G-Maveryck/OpenFlex-hardware/README.md

# OpenFlex-Project-hardware
Prototype for an Open source Flexfuel additionnal box
