G-Maveryck/OpenFlex-hardware/OpenFlex_Prototype/preview/Open_FlexFuel_Nano_THT_02.jpg

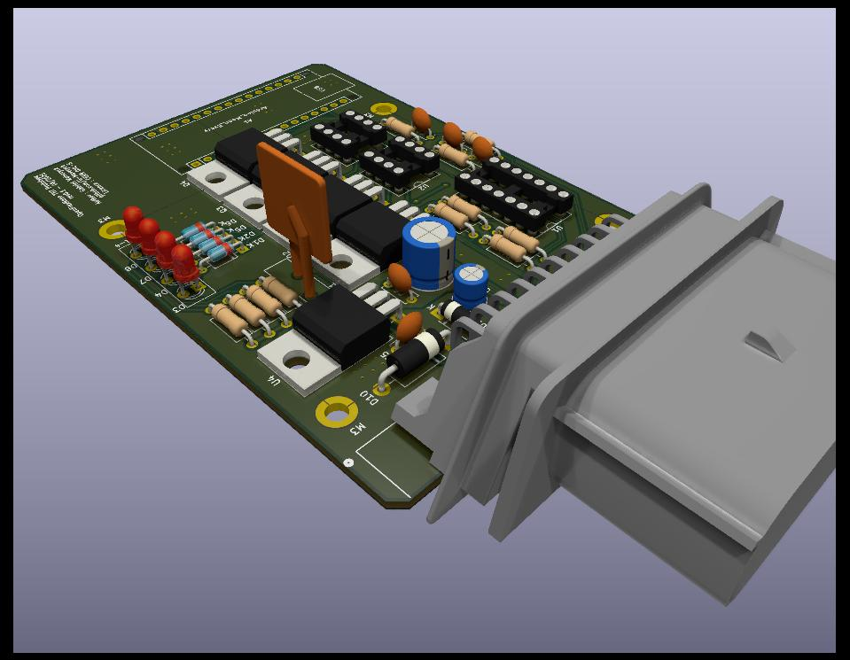
OpenFlex_Prototype/preview/Open_FlexFuel_Nano_THT_02.jpg
