G-Maveryck/OpenFlex-hardware/OpenFlex_Prototype/preview/Open_FlexFuel_Nano_THT_03.jpg

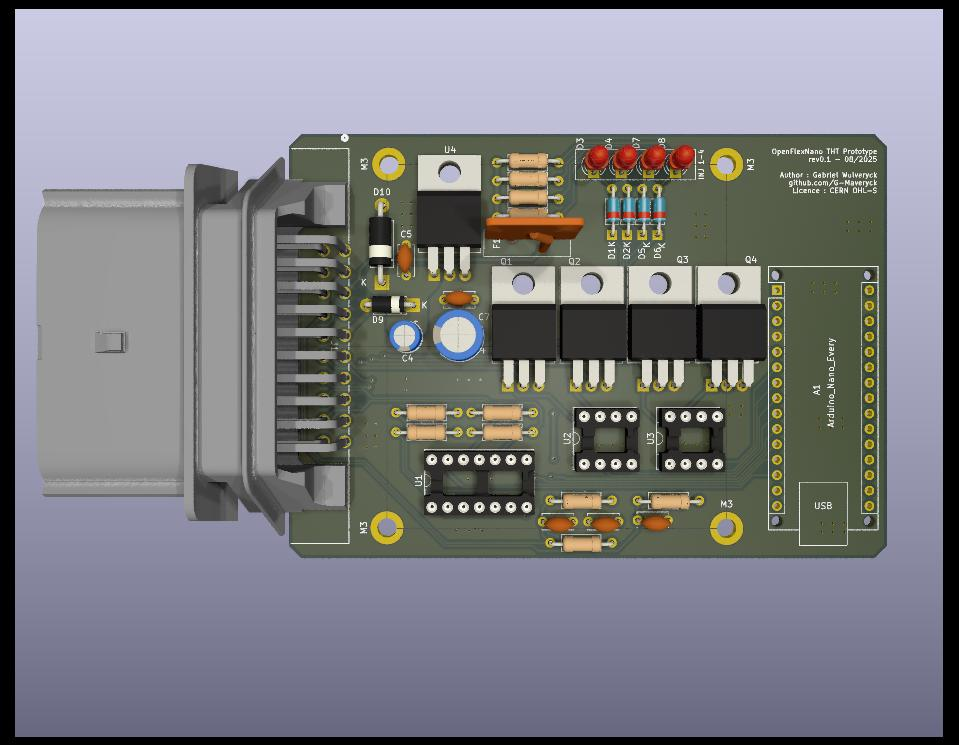
OpenFlex_Prototype/preview/Open_FlexFuel_Nano_THT_03.jpg
