G-Maveryck/OpenFlex-hardware/OpenFlex_Prototype/preview/Open_FlexFuel_Nano_THT_04.png

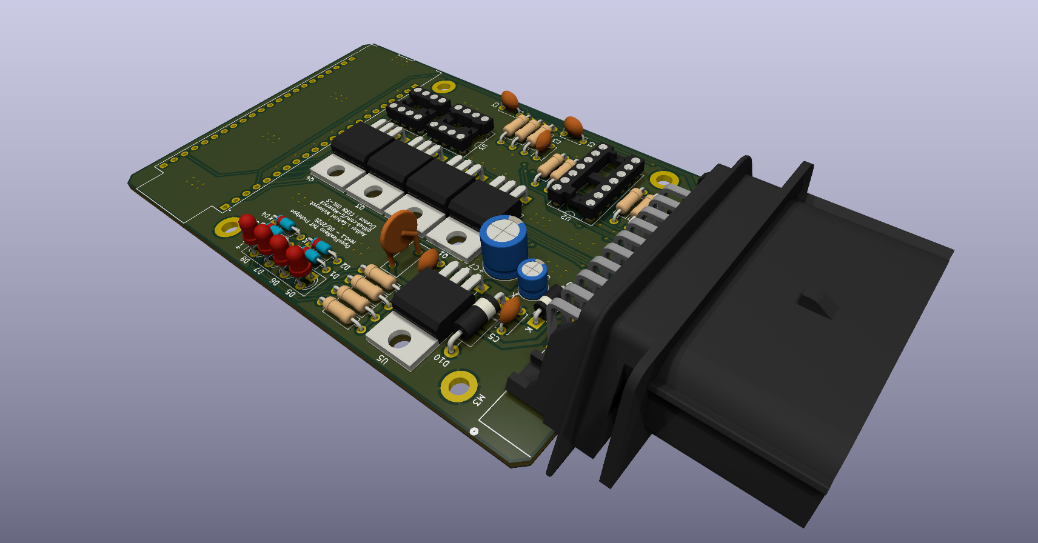
OpenFlex_Prototype/preview/Open_FlexFuel_Nano_THT_04.png
