G-Maveryck/OpenFlex-hardware/OpenFlex_Prototype/BOM_OpenFlex_Proto_THT.csv

Reference | Qty | Value | DNP | Exclude from BOM | Exclude from Board | Footprint | Datasheet | Manufacturer_Name | Mouser_Part_Number | Manufacturer_Part_Number | Mouser URL | Digikey_Part_Number
C1 | 1 | 100nF |  |  |  | Capacitor_THT:C_Disc_D5.0mm_W2.5mm_P5.00mm |  | TDK | 810-FA18X8R1E104KNU6 | FA18X8R1E104KNU06
C2,C3 | 2 | 220nF |  |  |  | Capacitor_THT:C_Disc_D5.0mm_W2.5mm_P5.00mm |  | TDK | 810-FA18X8R1E224KRU6 | FA18X8R1E224KRU06
C4 | 1 | 10uF |  |  |  | Capacitor_THT:CP_Radial_D5.0mm_P2.00mm |  | Panasonic | 667-EEU-FC1H100L | EEU-FC1H100L | https://www.mouser.fr/ProductDetail/Panasonic/EEU-FC1H100L?qs=y21It3NrCcwTwLLc39Q8Gg%3D%3D
C5,C6 | 2 | 0.1uF |  |  |  | Capacitor_THT:C_Disc_D5.0mm_W2.5mm_P5.00mm |  | TDK | 810-FA18X8R1E104KNU6 | FA18X8R1E104KNU06
C7 | 1 | 47uF |  |  |  | Capacitor_THT:CP_Radial_D8.0mm_P5.00mm |  | Panasonic | 667-EEU-FC1H470B | EEU-FC1H470B
D1,D2,D3,D4 | 4 | D |  |  |  | Diode_THT:D_DO-35_SOD27_P7.62mm_Horizontal |  | Vishay | 78-1N914-TAP,78-1N914-TAP | 1N914TAP
D5,D6,D7,D8 | 4 | LED |  |  |  | LED_THT:LED_D3.0mm |  | Wurth | 710-151031SS04000 | 151031SS04000
D9 | 1 | SB230-E3/54 |  |  |  | Diode_THT:D_DO-41_SOD81_P7.62mm_Horizontal | https://www.vishay.com/doc?88717 | Vishay Semiconductors | 625-SB230-E3 | SB230-E3/54 | https://www.mouser.fr/ProductDetail/Vishay-Semiconductors/SB230-E3-54?qs=u91jd7aysvMVfxBBDX1%252BYQ%3D%3D
D10 | 1 | TP6KE47A |  |  |  | Diode_THT:D_DO-15_P12.70mm_Horizontal |  | Littelfuse | 576-TP6KE47A | TP6KE47A
F1 | 1 | Polyfuse |  |  |  | Fuse:Fuse_BelFuse_0ZRE0005FF_L8.3mm_W3.8mm |  | Bel Fuse | 530-0ZRP0050FF1E | 0ZRP0050FF1E | https://www.mouser.fr/ProductDetail/Bel-Fuse/0ZRP0050FF1E?qs=gTYE2QTfZfSM60hMvV%252BG8g%3D%3D
J1 | 1 | Molex MAX150_2x10 |  |  | Exclure du PCB | Open_Flex_KiCadLibrary:Molex_CONN_MX150_20w |  | Molex | 538-33472-2001 | 33472-2001
J2 | 1 | Molex MAX150_2x10 |  |  |  | Open_Flex_KiCadLibrary:Molex_CONN_MX150_20w |  | Molex | 538-34830-2001 | 34830-2001
J3,J4,J5,J6,J7,J8,J9,J10,J11,J12,J13,J14,J15,J16,J17,J18,J19,J20,J21,J22 | 20 | Conn_01x01_Pin |  |  | Exclure du PCB |  |  | Molex | 538-33001-3004-LP | 33001-3004 (Loose Piece)
Q1,Q2,Q3,Q4 | 4 | STP80NF55-08 |  |  |  | Package_TO_SOT_THT:TO-220-3_Horizontal_TabDown |  | STMicroelectronics | 511-STP80NF55-08 | STP80NF55-08
R1,R2,R3,R4 | 4 | 10k |  |  |  | Resistor_THT:R_Axial_DIN0207_L6.3mm_D2.5mm_P10.16mm_Horizontal |  | YAGEO | 603-MFR-25FBF52-10K | MFR-25FBF52-10K
R5,R6,R7,R8 | 4 | 1k |  |  |  | Resistor_THT:R_Axial_DIN0207_L6.3mm_D2.5mm_P10.16mm_Horizontal |  | YAGEO | 603-MFR-25FBF52-1K | MFR-25FBF52-1K
R9 | 1 | 2.49k |  |  |  | Resistor_THT:R_Axial_DIN0207_L6.3mm_D2.5mm_P10.16mm_Horizontal |  | Stackpole Electronics Inc |  | RNF14BTE2K49 |  | 738-RNF14BTE2K49CT-ND
R10 | 1 | 470R |  |  |  | Resistor_THT:R_Axial_DIN0207_L6.3mm_D2.5mm_P10.16mm_Horizontal |  | YAGEO | 603-MFR-25FTE52-470R | MFR-25FTE52-470R
R11 | 1 | 2.4k |  |  |  | Resistor_THT:R_Axial_DIN0207_L6.3mm_D2.5mm_P10.16mm_Horizontal |  | Yageo | 603-MFR-25FBF52-2K4 | MFR-25FBF52-2K4
TH1 | 1 | 10k |  |  | Exclure du PCB |  |  | TDK |  | B57863S0103F040 |  | 495-2149-ND
U1 | 1 | ESP32-S2-DEVKITC-1 |  |  |  | Open_Flex_KiCadLibrary:MODULE_ESP32-S2-DEVKITC-1
U2 | 1 | LM324 |  |  |  | Package_DIP:DIP-14_W7.62mm_Socket | http://www.ti.com/lit/ds/symlink/lm2902-n.pdf | Texas Instrument | 595-LM324KAN | LM324KAN
U3,U4 | 2 | TC4424 |  |  |  | Package_DIP:DIP-8_W7.62mm_Socket |  | Microchip Technology | 579-TC4424AVPA | TC4424AVPA
U5 | 1 | LM2940S-5.0 |  |  |  | Package_TO_SOT_THT:TO-220-3_Horizontal_TabDown |  | Texas Instruments | 926-LM2940T-50/LF08 | LM2940T-5.0/LF08
