G-Maveryck/OpenFlex-hardware/OpenFlex_Enclosure/OpenFlex_Proto_Enclosure_rev0-2.FCStd

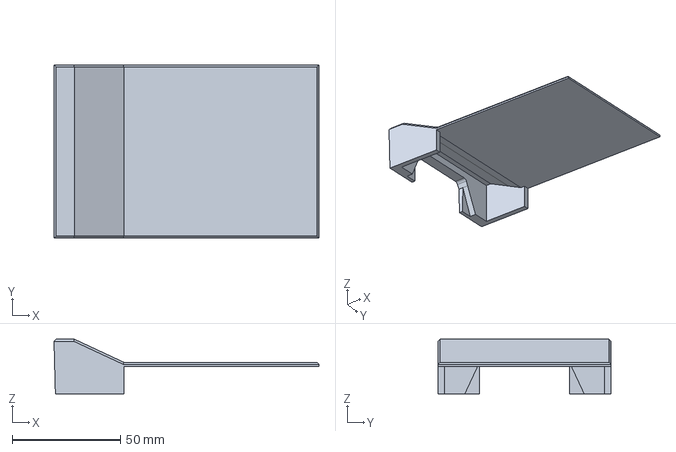
[picture p8: CAD file, 2026-08-11]
OpenFlex_Enclosure/OpenFlex_Proto_Enclosure_rev0-2.FCStd
122.3 x 79.9 x 25.2 mm
