G-Maveryck/OpenFlex-hardware/OpenFlex_Enclosure/OpenFlex_PCB.FCStd

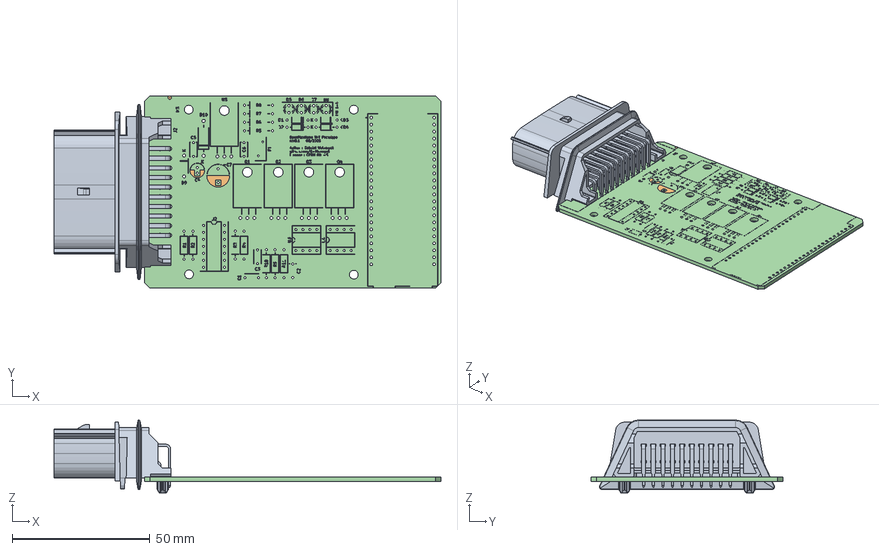
[picture p9: CAD file, 2026-07-14]
OpenFlex_Enclosure/OpenFlex_PCB.FCStd
140.7 x 69.9 x 26.5 mm
OpenFlex_Proto_THT_silkscreen
OpenFlex_Proto_THT_silkscreen001
OpenFlex_Proto_THT_PCB
