G-Maveryck/OpenFlex-hardware/OpenFlex_Enclosure/OpenFlex_Proto_PCB_rev0-2.step

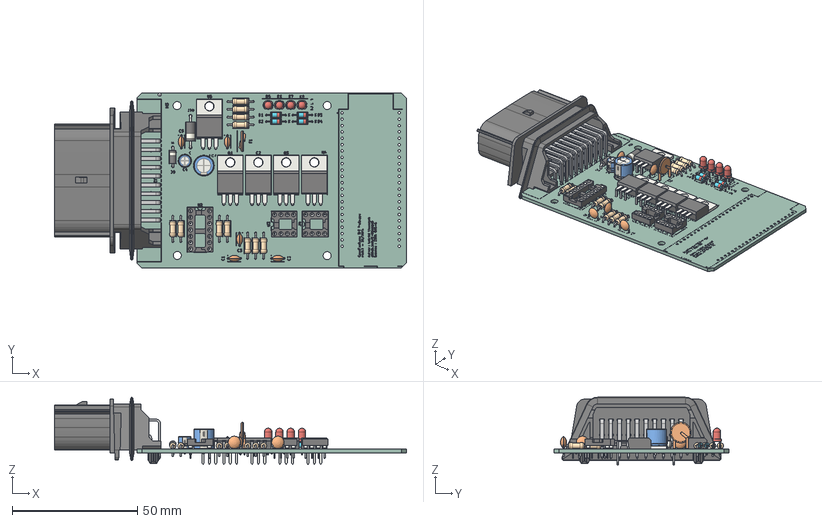
[picture p10: CAD file, 2026-07-14]
OpenFlex_Enclosure/OpenFlex_Proto_PCB_rev0-2.step
140.7 x 69.9 x 27.0 mm
DIP_8_W762mm_Socket x 2
D_DO-35_SOD27_P7.62mm_Horizontal x 4
CP_Radial_D50mm_P200mm
R_Axial_DIN0207_L63mm_D25mm_P1016mm_Horizontal x 11
TO-220-3_Horizontal_TabDown x 5
LED_D3.0mm x 4
C_Disc_D50mm_W25mm_P500mm x 5
D_DO-41_SOD81_P7.62mm_Horizontal
CP_Radial_D80mm_P500mm
D_DO-15_P12.70mm_Horizontal
A_0ZRE0005FF
DIP_14_W762mm_Socket
Open_FlexFuel_Nano_THT_silkscreen x 2
Open_FlexFuel_Nano_THT_PCB
