G-Maveryck/OpenFlex-hardware/OpenFlex_KiCadLibrary/3rdparty_stp/348302001.stp

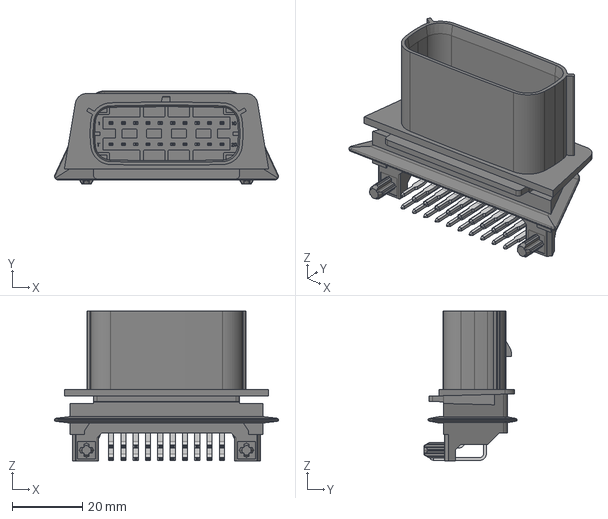
[picture p11: CAD file, 2026-04-27]
OpenFlex_KiCadLibrary/3rdparty_stp/348302001.stp
63.7 x 26.5 x 42.6 mm
