G-Maveryck/OpenFlex-hardware/(list of files, cad)

Other CAD files:
OpenFlex_Enclosure/ASS_OpenFlex.FCStd
OpenFlex_Enclosure/OpenFlex_Proto_PCB_rev0-2_Conn.step
