G-Maveryck/OpenFlex-hardware/OpenFlex_Prototype/OpenFlex_Proto_THT.kicad_pcb

## KiCad design OpenFlex_Prototype/OpenFlex_Proto_THT.kicad_pcb (2026-07-14)

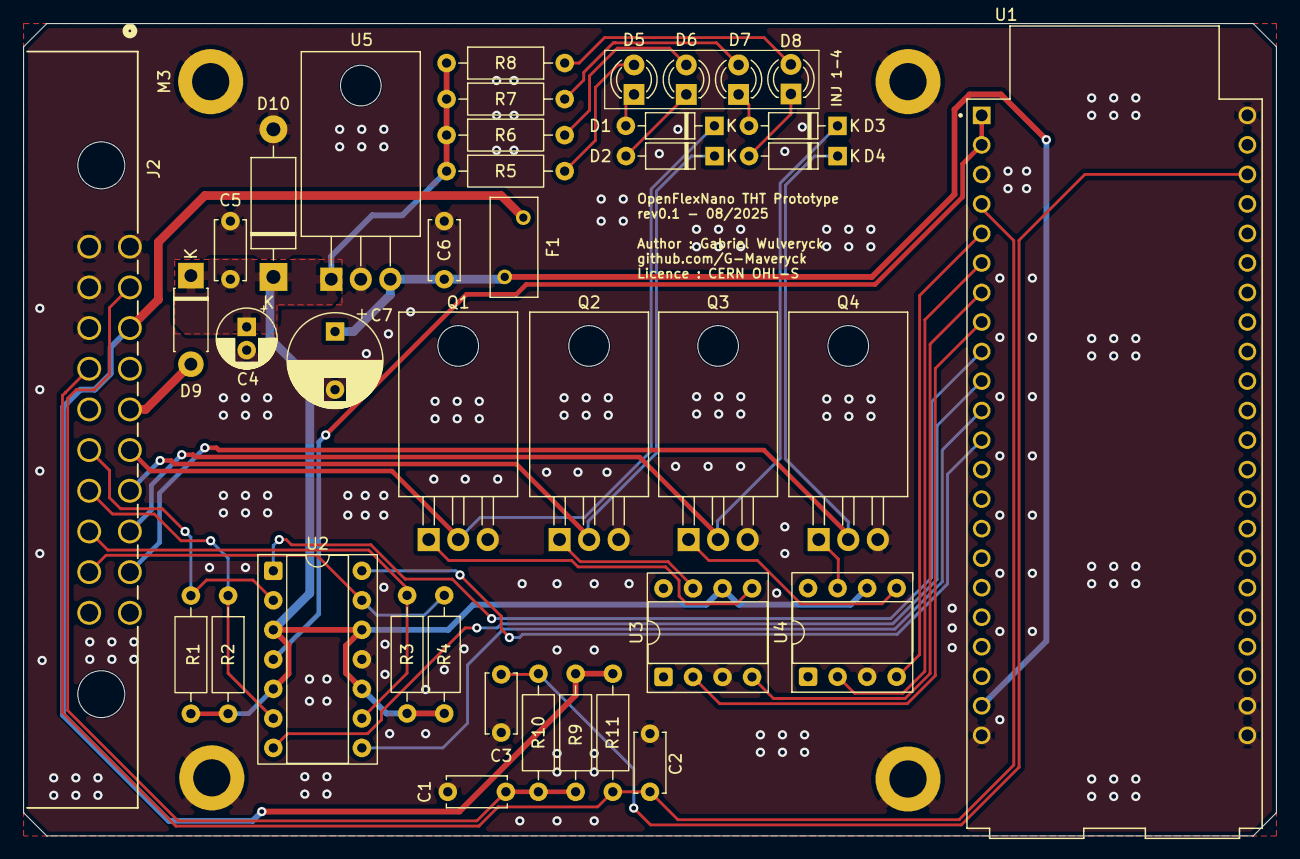
[picture p12: board OpenFlex_Proto_THT.kicad_pcb from above]

Board: 2 copper layers, 107.8 x 69.9 mm, 43 parts (0 on the bottom side), 37 nets.

Parts:
C1: 100nF; C_Disc_D5.0mm_W2.5mm_P5.00mm
C2, C3: 220nF; C_Disc_D5.0mm_W2.5mm_P5.00mm
C4: 10uF; CP_Radial_D5.0mm_P2.00mm
C5, C6: 0.1uF; C_Disc_D5.0mm_W2.5mm_P5.00mm
C7: 47uF; CP_Radial_D8.0mm_P5.00mm
D1, D2, D3, D4: D; D_DO-35_SOD27_P7.62mm_Horizontal
D5, D6, D7, D8: LED; LED_D3.0mm
D9: SB230-E3/54; D_DO-41_SOD81_P7.62mm_Horizontal
D10: TP6KE47A; D_DO-15_P12.70mm_Horizontal
F1: Polyfuse; Fuse_BelFuse_0ZRE0005FF_L8.3mm_W3.8mm
J2: Molex MAX150_2x10; Molex_CONN_MX150_20w
M3, M3#2, M3#3, M3#4: MountingHole_3.2mm_M3_DIN965_Pad
Q1, Q2, Q3, Q4: STP80NF55-08; TO-220-3_Horizontal_TabDown
R1, R2, R3, R4: 10k; R_Axial_DIN0207_L6.3mm_D2.5mm_P10.16mm_Horizontal
R5, R6, R7, R8: 1k; R_Axial_DIN0207_L6.3mm_D2.5mm_P10.16mm_Horizontal
R9: 2.49k; R_Axial_DIN0207_L6.3mm_D2.5mm_P10.16mm_Horizontal
R10: 470R; R_Axial_DIN0207_L6.3mm_D2.5mm_P10.16mm_Horizontal
R11: 2.4k; R_Axial_DIN0207_L6.3mm_D2.5mm_P10.16mm_Horizontal
U1: ESP32-S2-DEVKITC-1; MODULE_ESP32-S2-DEVKITC-1
U2: LM324; DIP-14_W7.62mm_Socket
U3, U4: TC4424; DIP-8_W7.62mm_Socket
U5: LM2940S-5.0; TO-220-3_Horizontal_TabDown

Connections:
+12V: C4.1, C5.1, D9.1 (K), D10.1 (K), R1.2, R2.2, R3.2, R4.2, R5.1, R6.1, R7.1, R8.1, U2.3 (+), U2.5 (+), U2.10 (+), U2.12 (+), U3.6 (VDD), U4.6 (VDD), U5.1 (VI)
/Connector/Flex_snsr_SIGN: C2.1, J2.14, R11.2, U1.J1_4 (GPIO4)
/Connector/INJ_+12V: D9.2 (A), J2.5
/Connector/INJ_CH1: J2.16, R1.1, U2.2 (-)
/Connector/INJ_CH2: J2.17, R2.1, U2.6 (-)
/Connector/INJ_CH3: J2.18, R3.1, U2.9 (-)
/Connector/INJ_CH4: J2.19, R4.1, U2.13 (-)
/Connector/INJ_DRIVE_CH1: D1.1 (K), J2.6, Q1.2 (D)
/Connector/INJ_DRIVE_CH2: D2.1 (K), J2.7, Q2.2 (D)
/Connector/INJ_DRIVE_CH3: D3.1 (K), J2.8, Q3.2 (D)
/Connector/INJ_DRIVE_CH4: D4.1 (K), J2.9, Q4.2 (D)
/Connector/Temp_snsr_V+: C1.1, J2.2, R9.1, R10.2
/IO_Drivers/INJ_SIGNAL_CH1: U1.J1_9 (GPIO16), U2.1
/IO_Drivers/INJ_SIGNAL_CH2: U1.J1_10 (GPIO17), U2.7
/IO_Drivers/INJ_SIGNAL_CH3: U1.J1_11 (GPIO18), U2.8
/IO_Drivers/INJ_SIGNAL_CH4: U1.J1_12 (GPIO8), U2.14
/IO_Drivers/MCU_INJ1: U1.J1_7 (GPIO7), U3.4 (IN_B)
/IO_Drivers/MCU_INJ2: U1.J1_8 (GPIO15), U3.2 (IN_A)
/IO_Drivers/MCU_INJ3: U1.J1_5 (GPIO5), U4.4 (IN_B)
/IO_Drivers/MCU_INJ4: U1.J1_6 (GPIO6), U4.2 (IN_A)
/IO_Drivers/Temp_Signal: C3.1, R10.1, U1.J3_3 (U0RXD)
GND: C1.2, C2.2, C3.2, C4.2, C5.2, C6.2, C7.2, D10.2 (A), J2.1, J2.11, J2.12, J2.13, M3.1, M3#2.1, M3#3.1, M3#4.1, Q1.3 (S), Q2.3 (S), Q3.3 (S), Q4.3 (S), U1.J1_22 (GND_J1_22), U1.J3_1 (GND_J3_1), U1.J3_21 (GND_J3_21), U1.J3_22 (GND_J3_22), U2.11 (V-), U3.3 (GND), U4.3 (GND), U5.2 (GND)
unnamed: D1.2 (A), D5.1 (K)
unnamed: D2.2 (A), D6.1 (K)
unnamed: D3.2 (A), D7.1 (K)
unnamed: D4.2 (A), D8.1 (K)
unnamed: D5.2 (A), R5.2
unnamed: D6.2 (A), R6.2
unnamed: D7.2 (A), R7.2
unnamed: D8.2 (A), R8.2
unnamed: Q1.1 (G), U3.5 (OUT_B)
unnamed: Q2.1 (G), U3.7 (OUT_A)
unnamed: Q3.1 (G), U4.5 (OUT_B)
unnamed: Q4.1 (G), U4.7 (OUT_A)
VDD: C6.1, C7.1, F1.2, U1.J1_21 (VCC_5V), U5.3 (VO)
VDDA: F1.1, J2.3, R9.2, R11.1
VSS: U1.J1_1 (3V3_J1_1), U1.J1_2 (3V3_J1_2), U2.4 (V+)
