G-Maveryck/OpenFlex-hardware/EmulatorBoard/EmulatorBoard.kicad_pcb

## KiCad design EmulatorBoard/EmulatorBoard.kicad_pcb (2026-06-13)

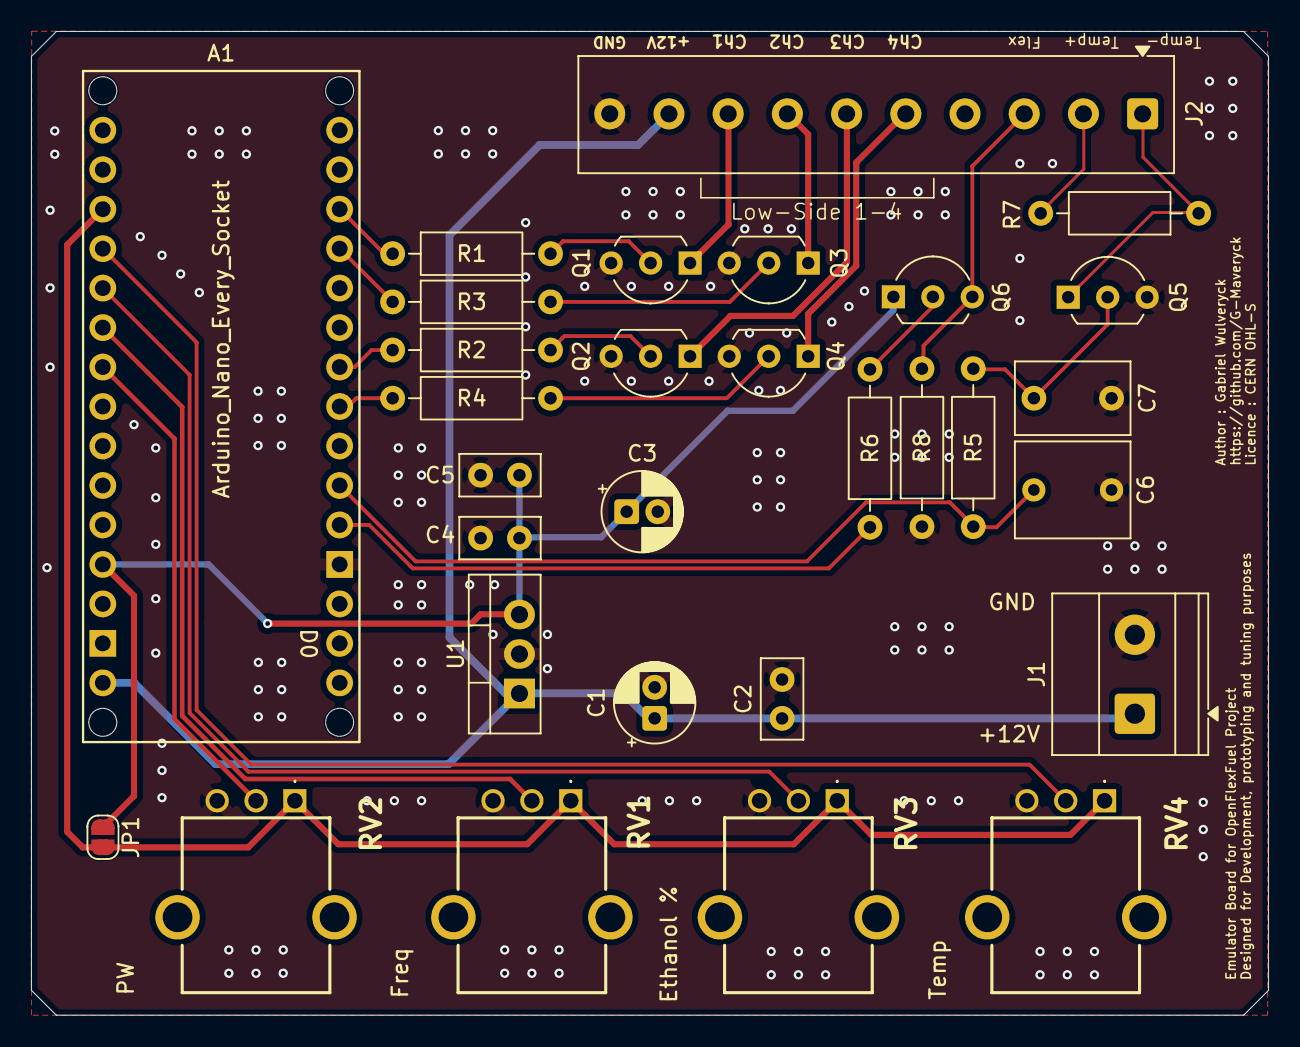
[picture p13: board EmulatorBoard.kicad_pcb from above]

Board: 2 copper layers, 79.6 x 63.3 mm, 30 parts (0 on the bottom side), 27 nets.

Parts:
A1: Arduino_Nano_Every_Socket
C1, C3: 10uF; CP_Radial_D5.0mm_P2.00mm
C2, C4: 1nF; C_Disc_D5.0mm_W2.5mm_P2.50mm
C5: 100nF; C_Disc_D5.0mm_W2.5mm_P2.50mm
C6: 1uF; C_Rect_L7.2mm_W6.0mm_P5.00mm
C7: 100nF; C_Rect_L7.2mm_W4.5mm_P5.00mm_FKS2_FKP2_MKS2_MKP2
J1: Screw_Terminal_01x02; TerminalBlock_Phoenix_MKDS-1,5-2-5.08_1x02_P5.08mm_Horizont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
J2: Screw_Terminal_01x10; TerminalBlock_Phoenix_MKDS-1-10-3.81_1x10_P3.81mm_Horizontal
JP1: SolderJumper_2_Open; SolderJumper-2_P1.3mm_Open_RoundedPad1.0x1.5mm
Q1, Q2, Q3, Q4, Q5, Q6: 2N2222A; TO-92L_Inline_Wide
R1, R2, R3, R4, R5, R6, R7, R8: 1k; R_Axial_DIN0207_L6.3mm_D2.5mm_P10.16mm_Horizontal
RV1, RV2, RV3, RV4: 100k Lin; PTN091V100115K1B
U1: LM7805_TO220; TO-220-3_Vertical

Connections:
+12V: A1.VIN, C1.1, C2.1, J1.1, J2.9, U1.1 (VI)
/AREF_Pin: A1.AREF, JP1.2 (B), RV1.1, RV2.1, RV3.1, RV4.1
/Eperct_Pot: A1.A1, RV3.2
/FREQ_Pot: A1.A2, RV1.2
/GD_CH1: A1.D10, R1.1
/GD_CH2: A1.D9, R3.1
/GD_CH3: A1.D6, R2.1
/GD_CH4: A1.D5, R4.1
/INJ_CH1: J2.8, Q1.1 (C)
/INJ_CH2: J2.7, Q3.1 (C)
/INJ_CH3: J2.6, Q2.1 (C)
/INJ_CH4: J2.5, Q4.1 (C)
/MCU_D2: A1.D2, R6.1
/MCU_D3: A1.D3, C6.1, R5.1
/PW_Pot: A1.A3, RV2.2
/Temp_Pot: A1.A0, RV4.2
Flex_SNSR_Signal: J2.3, Q6.3 (E), R8.2
GND: A1.GND1 (GND), A1.GND2 (GND), C1.2, C2.2, C3.2, C4.2, C5.2, C6.2, C7.2, J1.2, J2.10, Q1.3 (E), Q2.3 (E), Q3.3 (E), Q4.3 (E), Q5.3 (E), R8.1, RV1.3, RV2.3, RV3.3, RV4.3, U1.2 (GND)
unnamed: Q1.2 (B), R1.2
unnamed: Q2.2 (B), R2.2
unnamed: Q3.2 (B), R3.2
unnamed: Q4.2 (B), R4.2
unnamed: C7.1, Q5.2 (B), R5.2
unnamed: Q6.2 (B), R6.2
Temp_+: J2.2, R7.2
Temp_-: J2.1, Q5.1 (C), R7.1
VDD: A1.5V, C3.1, C4.1, C5.1, JP1.1 (A), Q6.1 (C), U1.3 (VO)
