G-Maveryck/OpenFlex-hardware/OpenFlex_SMD/OpenFlex_SMD.kicad_pcb

## KiCad design OpenFlex_SMD/OpenFlex_SMD.kicad_pcb (2026-04-27)

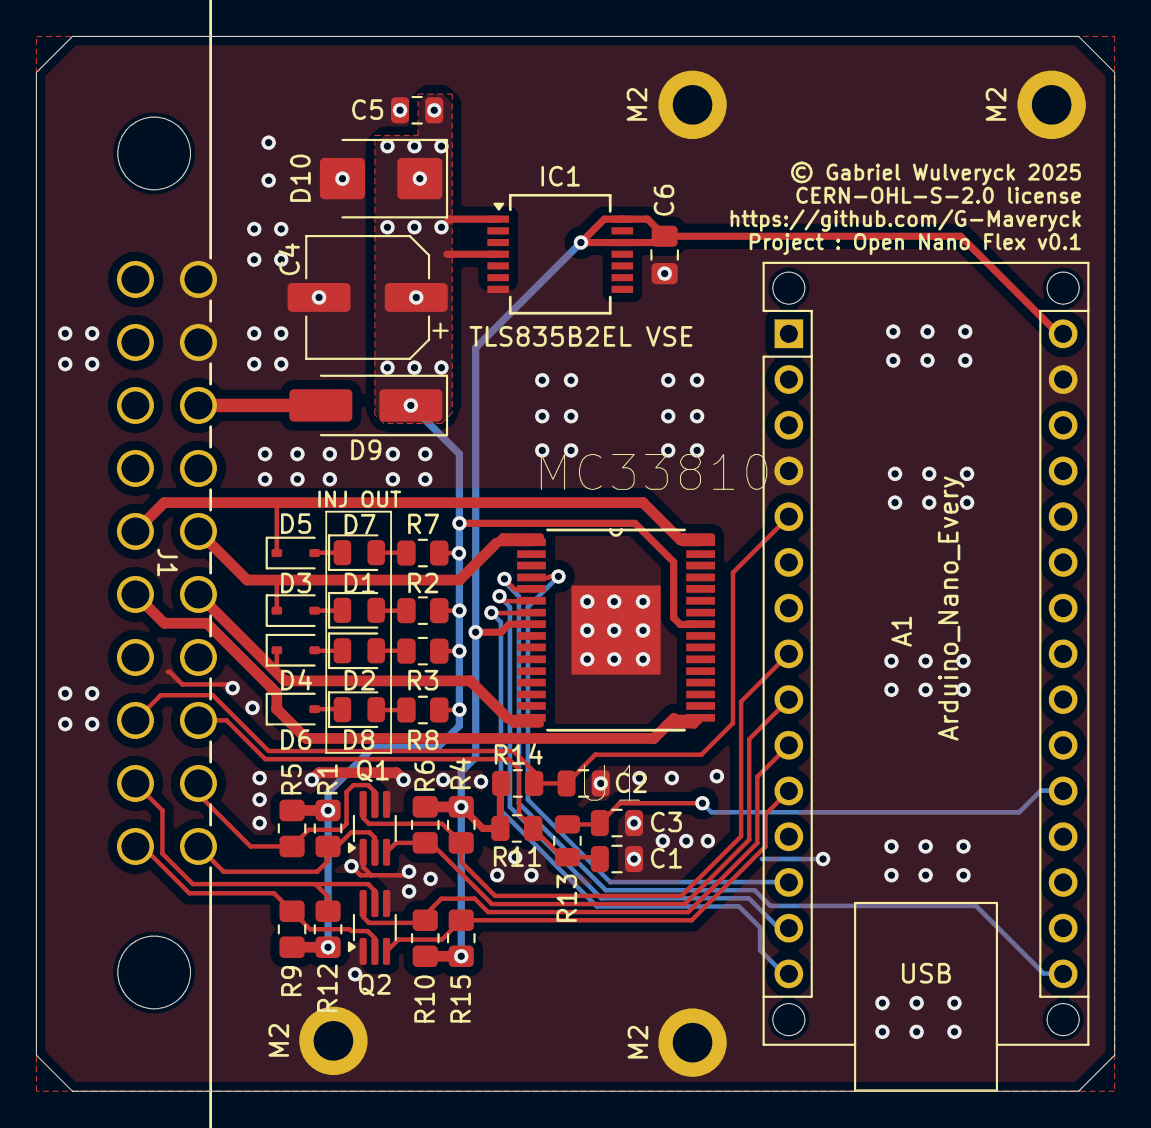
[picture p14: board OpenFlex_SMD.kicad_pcb from above]

Board: 2 copper layers, 59.9 x 58.6 mm, 41 parts (0 on the bottom side), 31 nets.

Parts:
A1: Arduino_Nano_Every; Arduino_Nano_WithMountingHoles
C1: 0.1uF; C_0805_2012Metric
C2: 270nF; C_0805_2012Metric
C3: 0.22uF; C_0805_2012Metric
C4: 33uF; CP_Elec_6.3x7.7
C5: 100nF; C_0805_2012Metric
C6: 1uF; C_0805_2012Metric_Pad1.18x1.45mm_HandSolder
D1, D2, D7, D8: LED; LED_0805_2012Metric
D3, D4, D5, D6: D; D_SOD-323
D9: B360A-13-F; D_SMA_Handsoldering
D10: SMBJ40A-Q; D_SMB
IC1: TLS835B2EL VSE; SSOP-14_5.3x6.2mm_P0.65mm
J1: Conn_02x10_Counter_Clockwise; Molex_CONN_MX150_20w
M2, M2#2, M2#3, M2#4: MountingHole_2.2mm_M2_DIN965_Pad
Q1, Q2: Q_Dual_NMOS_S1G1D2S2G2D1; SOT-363_SC-70-6_Handsoldering
R1, R5, R9, R12: 10k; R_0805_2012Metric_Pad1.20x1.40mm_HandSolder
R2, R3, R7, R8: 1k; R_0805_2012Metric
R4, R6, R10, R15: 1k; R_0805_2012Metric_Pad1.20x1.40mm_HandSolder
R11: 2.49k; R_0805_2012Metric
R13: 470R; R_0805_2012Metric
R14: 2.4k; R_0805_2012Metric
U1: MC33810; SOIC32-P0.65-33N

Connections:
+5V: A1.30 (VIN), C6.1, IC1.12 (SEL), IC1.14 (OUT/Q), R4.1, R6.1, R10.1, R11.2, R14.1, R15.1, U1.8 (VDD)
+12V: C4.1, C5.1, D9.1 (K), D10.1 (K), IC1.1 (IN), IC1.4 (EN), R1.2, R2.1, R3.1, R5.2, R7.2, R8.2, R9.2, R12.2, U1.25 (VPWR)
/Connector/Flex_snsr: A1.5 (D2), C2.1, J1.18, R14.2
/Connector/INJ_+12V: D9.2 (A), J1.3
/Connector/INJ_CH1: J1.10, Q1.2 (G), R1.1
/Connector/INJ_CH2: J1.9, Q1.5 (G), R5.1
/Connector/INJ_CH3: J1.20, Q2.2 (G), R9.1
/Connector/INJ_CH4: J1.19, Q2.5 (G), R12.1
/Connector/INJ_DRIVE_CH1: D5.1 (K), J1.15, U1.32 (OUT2)
/Connector/INJ_DRIVE_CH2: D3.1 (K), J1.5, U1.1 (OUT0)
/Connector/INJ_DRIVE_CH3: D4.1 (K), J1.6, U1.16 (OUT1)
/Connector/INJ_DRIVE_CH4: D6.1 (K), J1.16, U1.17 (OUT3)
/Connector/Temp_snsr: C1.1, J1.8, R11.1, R13.2
/IO_Drivers/INJ_SIGNAL_CH1: A1.8 (D5), Q1.6 (D), R4.2
/IO_Drivers/INJ_SIGNAL_CH2: A1.9 (D6), Q1.3 (D), R6.2
/IO_Drivers/INJ_SIGNAL_CH3: A1.10 (D7), Q2.6 (D), R10.2
/IO_Drivers/INJ_SIGNAL_CH4: A1.11 (D8), Q2.3 (D), R15.2
/IO_Drivers/MC33810_CS: A1.13 (D10), U1.4 (CS)
/IO_Drivers/MISO: A1.15 (MISO), U1.7 (SO)
/IO_Drivers/MOSI: A1.14 (MOSI), U1.6 (SI)
/IO_Drivers/SCLK: A1.16 (SCK), U1.5 (SCLK)
/IO_Drivers/Temp_Signal: A1.20 (A1), C3.1, R13.1
GND: A1.4 (GND), A1.29 (GND), C1.2, C2.2, C3.2, C4.2, C5.2, C6.2, D10.2 (A), IC1.7 (GND), J1.1, J1.2, M2.1, M2#2.1, M2#3.1, M2#4.1, Q1.1 (S), Q1.4 (S), Q2.1 (S), Q2.4 (S), U1.33 (GND)
unnamed: D1.2 (A), R2.2
unnamed: D1.1 (K), D3.2 (A)
unnamed: D2.2 (A), R3.2
unnamed: D2.1 (K), D4.2 (A)
unnamed: D5.2 (A), D7.1 (K)
unnamed: D6.2 (A), D8.1 (K)
unnamed: D7.2 (A), R7.1
unnamed: D8.2 (A), R8.1
