G-Maveryck/OpenFlex-hardware/(commit log)

2026-04-27 Initial Commit
    Choosed ESP32 for development platform. Production version will integrate the ESP32 SoC, and SMD componants.
    [348302001.stp, EmulatorBoard.kicad_pcb, EmulatorBoard.kicad_sch, Open_FlexFuel_Nano.kicad_pcb, Open_FlexFuel_Nano.kicad_sch, Open_FlexFuel_Nano_THT.kicad_pcb, Open_FlexFuel_Nano_THT.kicad_sch, PCB_Open_FlexFuel_Nano_THT.step]
2026-04-27 removed old stl pcb file
    useless lol
2026-05-26 Updated PCB to ESP32-S2-Devkit-C1
    [Open_FlexFuel_Nano_THT.kicad_pcb, Open_FlexFuel_Nano_THT.kicad_sch, conn.kicad_sch, io_drivers.kicad_sch, mcu.kicad_sch, pwr.kicad_sch]
2026-05-28 Updated and sourced EmulatoBoard (DevBoard)
    [EmulatorBoard.kicad_pcb, EmulatorBoard.kicad_sch, EmulatorBoard_BOM.csv, Open_FlexFuel_Nano_THT.kicad_pcb, PCB_Open_FlexFuel_Nano_THT.step, PCB_Open_FlexFuel_Nano_THT_02.step, io_drivers.kicad_sch, pwr.kicad_sch]
2026-05-28 Updated Sourcing for prototype
    [Open_FlexFuel_Nano_THT.kicad_pcb, conn.kicad_sch, io_drivers.kicad_sch, pwr.kicad_sch]
2026-05-29 Enclosure WIP
    [OpenFlex_PCB_Conn.FCStd, OpenFlex_Proto_Enclosure_v1_Parts.FCStd, Open_FlexFuel_Nano_THT.kicad_pcb, pwr.kicad_sch]
2026-05-30 Actualized file name
    [OpenFlex_Proto_THT.kicad_pcb, OpenFlex_Proto_THT.kicad_sch, Open_FlexFuel_Nano_THT.kicad_sch, conn.kicad_sch, io_drivers.kicad_sch, mcu.kicad_sch, pwr.kicad_sch]
2026-06-05 Updated BOM
    [BOM_OpenFlex_Proto_THT.csv, OpenFlex_PCB_Conn.FCStd, OpenFlex_Proto_Enclosure_v1_Parts.FCStd, OpenFlex_Proto_THT.kicad_pcb, OpenFlex_SMD.kicad_pcb, OpenFlex_SMD.kicad_sch, Open_FlexFuel_Nano.kicad_sch, conn.kicad_sch]
2026-07-14 BOM Updated with thermistor. Enclosure in progress
    [ASS_OpenFlex.FCStd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]
2026-07-18 Enclosure in progress
    Lid finished drawing. Sealing in progress
    [ASS_OpenFlex.FCStd, OpenFlex_Proto_Enclosure_rev0-2.FCStd]
2026-07-21 Reworked Enclosure
    [ASS_OpenFlex.FCStd, OpenFlex_Proto_Enclosure_rev0-2.FCStd]
2026-08-11 Workin on enclosure
    [ASS_OpenFlex.FCStd, OpenFlex_Proto_Enclosure_rev0-2.FCStd]
