G-Maveryck/OpenFlex-hardware/(notices)

Notices in the files:
OpenFlex_SMD/OpenFlex_SMD.kicad_pcb:
© Gabriel Wulveryck 2025
CERN-OHL-S-2.0 license
EmulatorBoard/EmulatorBoard.kicad_pcb:
Licence : CERN OHL-S
